WojLip/Robot-Kroczacy/README.md

# Robot Kroczący
Projekt IPZ 2022/2023 </br>
Film prezentacja:</br>
https://drive.google.com/file/d/1JbjSwrBRrF581w90QR2xEMyqwC6iqoWT/view
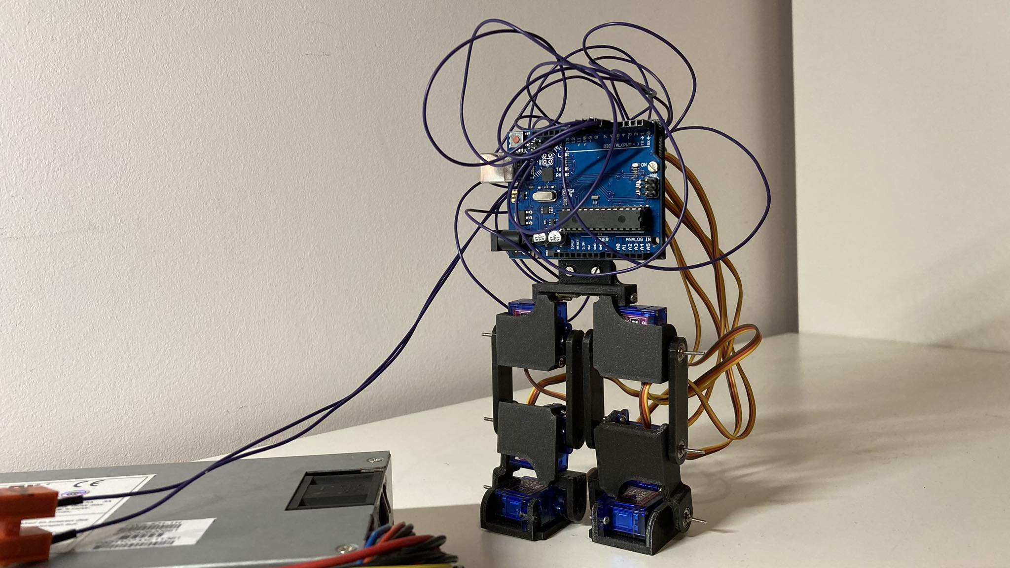
[picture p1: robot.jpg]
robot

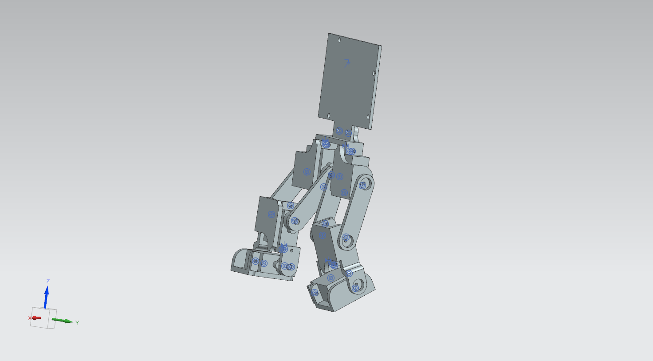
[picture p2: model1.png]
model1
