WojLip/Robot-Kroczacy/(list of files, cad)

Other CAD files:
model/czesci/Testownik.prt
model/czesci/Udo.prt
model/czesci/biodroLewe.prt
model/czesci/biodroPrawe.prt
model/czesci/kolanoLewe.prt
model/czesci/kolanoPrawe.prt
model/czesci/lacznik stopy.prt
model/czesci/lacznikGora.prt
model/czesci/servo.prt
model/czesci/stopaPrawa.prt
model/czesci/stopalewa.prt
model/czesci/uchwytNaArduino.prt
model/czesci/udowewnetrzne.prt
model/zlozenie.prt
